jimstump/trinket-m0-physical-mute-button-for-video-chat/(commit log)

2020-09-30 Adding the current code for the hardware mute button prototype.
    At this point, it is a fairly feature complete MVP. It supports microphone and video camera toggles for Zoom, Google Meet, Microsoft Teams, and WebEx (no video camera toggle). It also supports using a potentiometer as a application switch.
2020-09-30 Fixed the typo in the comment header
    [html_color_names.h]
2020-10-02 I expanded upon the README.
    I also removed the duplicate README contents from the top of the .ino file so I didn't have to maintain two copies.
    [trinket-m0-physical-mute-button-for-video-chat.ino]
2020-10-02 Added an example wiring diagram to help explain how everything goes together.
2020-10-18 Updated the parts list with the micro-USB panel mount connector.
    I had some issues with the USB C connector, specifically getting power using a USB C to USB C cable, so I switched it out. I also made some minor copy changes to the README as well.
2020-10-24 Improved the 'Enclosure' and 'Programming' sections of the README.
    Also added the MacOS Keyboard Setup Assistant screenshot and added a section about the labels I used.
